vijay-prema/OpenUPS2-enclosure/preview/walls.png

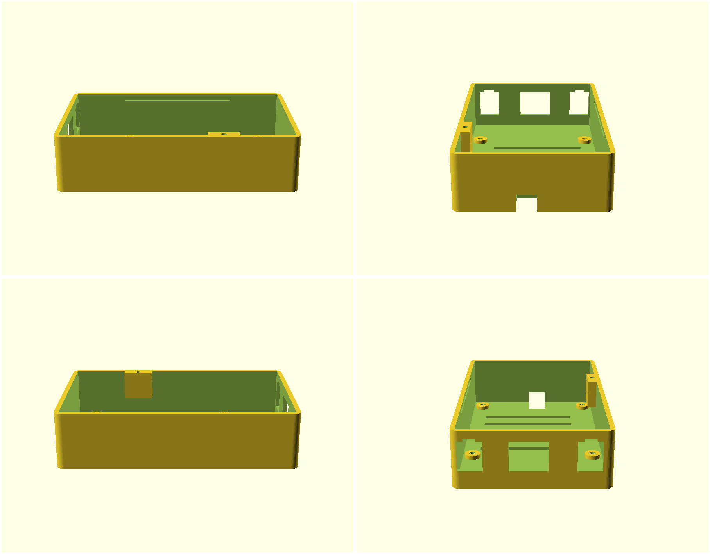
preview/walls.png
