vijay-prema/OpenUPS2-enclosure/base.stl

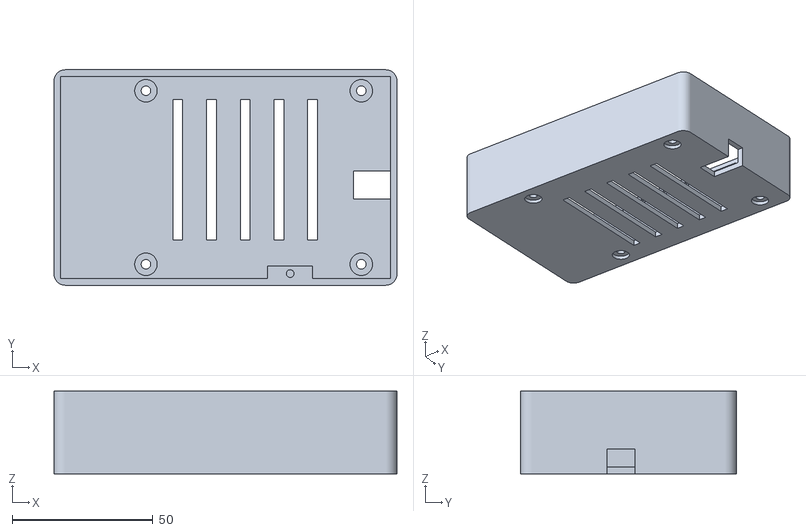
[picture p4: CAD file, 2026-11-01]
base.stl
122.0 x 76.7 x 29.4
