vijay-prema/OpenUPS2-enclosure/lid.stl

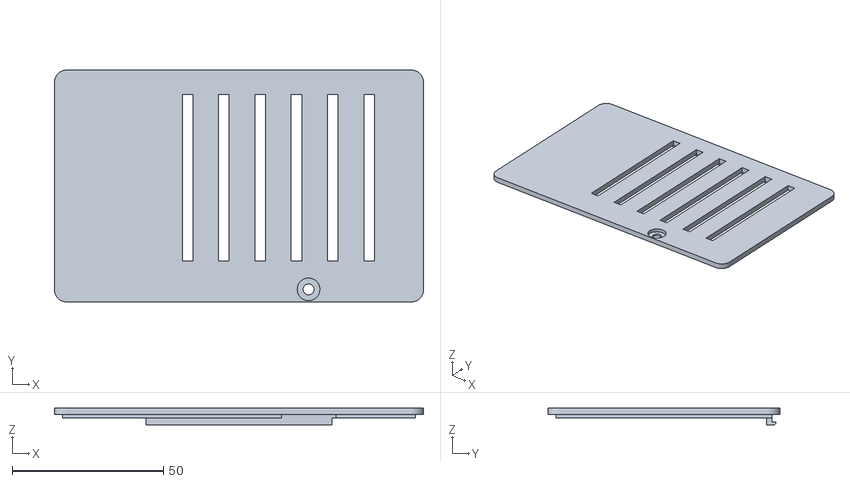
[picture p5: CAD file, 2026-11-01]
lid.stl
122.0 x 76.7 x 5.60
