vijay-prema/OpenUPS2-enclosure/board_in_case.stl

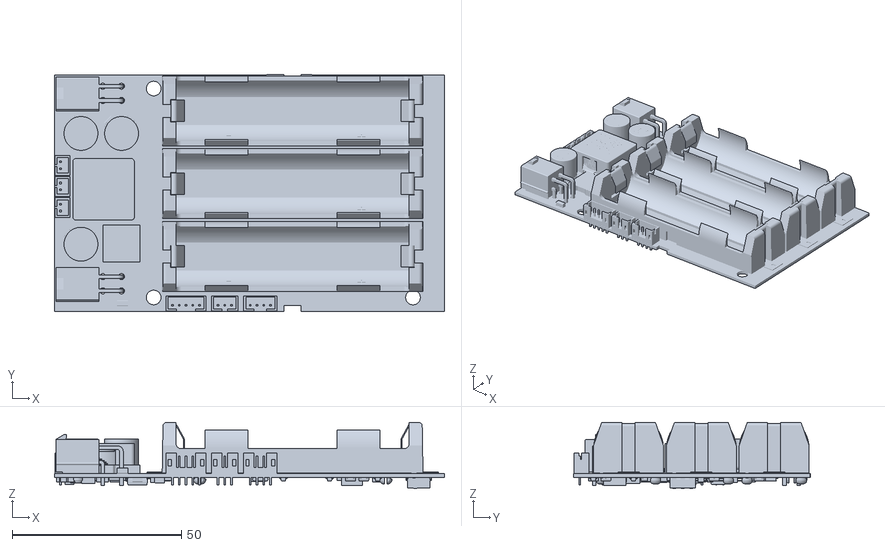
[picture p6: CAD file, 2026-11-01]
board_in_case.stl
115.2 x 69.9 x 19.5
