vijay-prema/OpenUPS2-enclosure/(commit log)

2026-11-01 First version printed
    [assembly.scad, base.stl, board_in_case.stl, enclosure.scad, lid.stl]
2026-11-01 Rev F: Adjust screw counterbores to fit wider heads, add photo of print
    [base.stl, enclosure.scad, lid.stl]
